AIAYN-creator/monkey-with-a-scalpel/docs/connection_map.md

# Connection map (generated by `python cad/connection_map.py`; provisional)

Every conductor from its pin in the electronics box to its pin at the machine. Pins of the controller come from `board_config.h`; cables, lengths and conductor counts from `cad/wiring.py`. Nothing here is measured or verified.

## C1: X motor (NEMA 17, at the crossbeam end) (0.7 m)

| # | Signal | Box end | Machine end |
|---|---|---|---|
| 1 | X motor coil A + | D_X.M1A | X motor.coilA+ |
| 2 | X motor coil A - | D_X.M1B | X motor.coilA- |
| 3 | X motor coil B + | D_X.M2A | X motor.coilB+ |
| 4 | X motor coil B - | D_X.M2B | X motor.coilB- |

## C3: Y motor (NEMA 17, on the X carriage) (1.2 m)

| # | Signal | Box end | Machine end |
|---|---|---|---|
| 1 | Y motor coil A + | D_Y.M1A | Y motor.coilA+ |
| 2 | Y motor coil A - | D_Y.M1B | Y motor.coilA- |
| 3 | Y motor coil B + | D_Y.M2A | Y motor.coilB+ |
| 4 | Y motor coil B - | D_Y.M2B | Y motor.coilB- |

## C5: Z motor (NEMA 17 dual shaft, on the Y carriage) (1.8 m)

| # | Signal | Box end | Machine end |
|---|---|---|---|
| 1 | Z motor coil A + | D_Z.M1A | Z motor.coilA+ |
| 2 | Z motor coil A - | D_Z.M1B | Z motor.coilA- |
| 3 | Z motor coil B + | D_Z.M2A | Z motor.coilB+ |
| 4 | Z motor coil B - | D_Z.M2B | Z motor.coilB- |

## C12: Wrist axis A motor (NEMA 11) (2.2 m)

| # | Signal | Box end | Machine end |
|---|---|---|---|
| 1 | Wrist A motor coil A + | D_A.M1A | Wrist A motor.coilA+ |
| 2 | Wrist A motor coil A - | D_A.M1B | Wrist A motor.coilA- |
| 3 | Wrist A motor coil B + | D_A.M2A | Wrist A motor.coilB+ |
| 4 | Wrist A motor coil B - | D_A.M2B | Wrist A motor.coilB- |

## C13: Wrist axis B motor (NEMA 11) (2.2 m)

| # | Signal | Box end | Machine end |
|---|---|---|---|
| 1 | Wrist B motor coil A + | D_B.M1A | Wrist B motor.coilA+ |
| 2 | Wrist B motor coil A - | D_B.M1B | Wrist B motor.coilA- |
| 3 | Wrist B motor coil B + | D_B.M2A | Wrist B motor.coilB+ |
| 4 | Wrist B motor coil B - | D_B.M2B | Wrist B motor.coilB- |

## C2: X limit switches, min and max (common ground) (0.7 m)

| # | Signal | Box end | Machine end |
|---|---|---|---|
| 1 | X minimum switch | U1.GPIO1 | SW_X-.NC |
| 2 | X maximum switch | U1.GPIO2 | SW_X+.NC |
| 3 | switch common ground | GND_LOGIC | SW_X-.C and SW_X+.C |

## C4: Y limit switches, min and max (common ground) (1.2 m)

| # | Signal | Box end | Machine end |
|---|---|---|---|
| 1 | Y minimum switch | U1.GPIO21 | SW_Y-.NC |
| 2 | Y maximum switch | U1.GPIO38 | SW_Y+.NC |
| 3 | switch common ground | GND_LOGIC | SW_Y-.C and SW_Y+.C |

## C6: Z limit switch, top (1.8 m)

| # | Signal | Box end | Machine end |
|---|---|---|---|
| 1 | Z top switch | U1.GPIO40 | SW_Z+.NC |
| 2 | switch common ground | GND_LOGIC | SW_Z+.C |

## C8: Control panel: dual-contact e-stop and ABORT button (coil, enable loop, ABORT signal), pilot LED, common ground (1.0 m)

| # | Signal | Box end | Machine end |
|---|---|---|---|
| 1 | contactor coil supply to e-stop contact 1 | K1.A1 via ES1.11 loop | ES1.11 |
| 2 | e-stop contact 1 to the contactor coil | K1.A2 side | ES1.12 |
| 3 | enable loop out (5 V) | ENABLE_5V | ES1.21 |
| 4 | enable loop return (ES1.22 to AB1.21 in the panel) | ENABLE_OK | AB1.22 |
| 5 | ABORT button contact 1 | U1.GPIO41 | AB1.11 |
| 6 | common ground | GND_LOGIC | AB1.12 and LED1.K |
| 7 | pilot LED | U1.GPIO47 via resistor | LED1.A |

## C7: Head link: tool power 24 V and ground, RS-485 pair, enable signal, power permit, plunger motor phases (see HEAD_LINK) (2.2 m)

| # | Signal | Box end | Machine end |
|---|---|---|---|
| 1 | tool rail 24 V (1) | K1.TOOL_FUSE | HB.VIN1 |
| 2 | tool rail 24 V (2) | K1.TOOL_FUSE | HB.VIN2 |
| 3 | tool rail ground (1) | GND_POWER | HB.GND1 |
| 4 | tool rail ground (2) | GND_POWER | HB.GND2 |
| 5 | RS-485 A | T1.A | T2.A |
| 6 | RS-485 B | T1.B | T2.B |
| 7 | enable loop | ENABLE_OK | HB.ENABLE |
| 8 | power permit | U1.GPIO39 | HB.PERMIT |
| 9 | plunger motor A + | D_P.M1A | HB.PA1 |
| 10 | plunger motor A - | D_P.M1B | HB.PA2 |
| 11 | plunger motor B + | D_P.M2A | HB.PB1 |
| 12 | plunger motor B - | D_P.M2B | HB.PB2 |

## C9: Camera A (USB) (2.0 m)

| # | Signal | Box end | Machine end |
|---|---|---|---|
| 1 | Camera A USB VBUS | PC.USB_VBUS | Camera A.VBUS |
| 2 | Camera A USB D+ | PC.USB_D+ | Camera A.D+ |
| 3 | Camera A USB D- | PC.USB_D- | Camera A.D- |
| 4 | Camera A USB GND | PC.USB_GND | Camera A.GND |

## C10: Camera B (USB) (2.0 m)

| # | Signal | Box end | Machine end |
|---|---|---|---|
| 1 | Camera B USB VBUS | PC.USB_VBUS | Camera B.VBUS |
| 2 | Camera B USB D+ | PC.USB_D+ | Camera B.D+ |
| 3 | Camera B USB D- | PC.USB_D- | Camera B.D- |
| 4 | Camera B USB GND | PC.USB_GND | Camera B.GND |

## C11: Host PC to the controller (USB serial) (1.5 m)

| # | Signal | Box end | Machine end |
|---|---|---|---|
| 1 | Host PC USB VBUS | PC.USB_VBUS | U1.USB_VBUS |
| 2 | Host PC USB D+ | PC.USB_D+ | U1.USB_D+ |
| 3 | Host PC USB D- | PC.USB_D- | U1.USB_D- |
| 4 | Host PC USB GND | PC.USB_GND | U1.USB_GND |

## Inside the electronics box

| Controller pin | Goes to | Function |
|---|---|---|
| U1.GPIO4 | D_X.STEP | X step |
| U1.GPIO5 | D_Y.STEP | Y step |
| U1.GPIO6 | D_Z.STEP | Z step |
| U1.GPIO7 | D_A.STEP | A step |
| U1.GPIO15 | D_B.STEP | B step |
| U1.GPIO16 | D_P.STEP | P step |
| U1.GPIO17 | D_X.DIR | X direction |
| U1.GPIO18 | D_Y.DIR | Y direction |
| U1.GPIO8 | D_Z.DIR | Z direction |
| U1.GPIO9 | D_A.DIR | A direction |
| U1.GPIO10 | D_B.DIR | B direction |
| U1.GPIO11 | D_P.DIR | P direction |
| U1.GPIO12 | D_X.EN, D_Y.EN, D_Z.EN, D_A.EN, D_B.EN, D_P.EN | drivers enable (low = on) |
| U1.GPIO42 | OPTO1.OUT | motor power OK, after the contactor |
| U1.GPIO13 | T1.DI | head link transmit (reclaims the reserved UART TX) |
| U1.GPIO14 | T1.RO | head link receive (reclaims the reserved UART RX) |

## Power and safety nets

| From | To | What |
|---|---|---|
| PSU24.+ | F1 (fuse) to K1 main contacts 13-14 | 24 V from the supply to the contactor |
| K1.14 | D_X.VM, D_Y.VM, D_Z.VM, D_A.VM, D_B.VM, D_P.VM and the tool rail fuse | 24 V after the contactor: motors and tools |
| K1.14 via divider | OPTO1.IN | motor power OK sense |
| PSU5.+ | U1.5V, D_*.VIO, T1.VCC, ENABLE_5V source | 5 V logic, separate from the motors |
| ENABLE_5V | C8.3 to ES1.21, ES1.22 to AB1.21, AB1.22 to C8.4 (ENABLE_OK), then C7.7 to HB.ENABLE | the enable loop |
| PSU24.+ via ES1.11-12 | K1.A1, K1.A2 to PSU24.- | the e-stop opens the contactor coil |

## Tool connector (12 circuits) on the head board, by tool

Circuits 1-2 switched 24 V, 3-4 ground, 5 logic 5 V, 6 identification (1-wire). Circuits 7-12 by tool:

| Tool | Circuit: signal (kind) |
|---|---|
| injector | 7: plunger motor A+ (phase); 8: plunger motor A- (phase); 9: plunger motor B+ (phase); 10: plunger motor B- (phase) |
| probe | 7: stylus trigger contact (NC to ground) (in); 11: stylus force, optional (analog) |
| scalpel | 7: guard servo (pwm); 8: guard closed sensor (in) |
| drill | 7: motor speed (pwm); 8: motor enable (out); 9: tachometer (in); 11: motor current (analog) |
| fluid | 7: pump 1 (pwm); 8: pump 2 (pwm); 9: line valve (out); 11: line pressure (analog) |
| gripper | 7: jaw motor A+ (phase); 8: jaw motor A- (phase); 9: jaw motor B+ (phase); 10: jaw motor B- (phase); 11: jaw force (analog) |
| cautery | 7: pulse gate (out); 11: tip current (analog) |
| sensor | 7: light source (pwm); 11: detector (analog) |

## Parts that must be fitted

- E-stop and ABORT button with two normally closed contacts each (dual contact): contact 1 for the contactor coil and the ABORT pin, contact 2 for the enable loop
- RS-485 transceivers with automatic direction control at the controller (T1) and at the head board (T2)
- Head board: microcontroller, high-side tool power switch and the discrete AND of the enable loop and the power permit (see wiring.py HEAD_BOARD and HW_CUTOFF_NOTE)
- Four changeover relays or analog switches on the head board that route circuits 7-10 either to the plunger motor phases or to the head outputs, selected from the tool identifier; unpowered, the circuits are disconnected from both
