AIAYN-creator/monkey-with-a-scalpel/assets/brand/social-preview.png

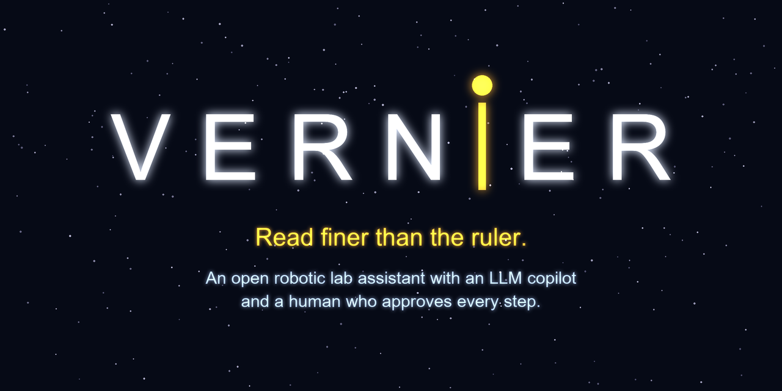
assets/brand/social-preview.png
