AIAYN-creator/monkey-with-a-scalpel/assets/brand/wordmark-dark.png

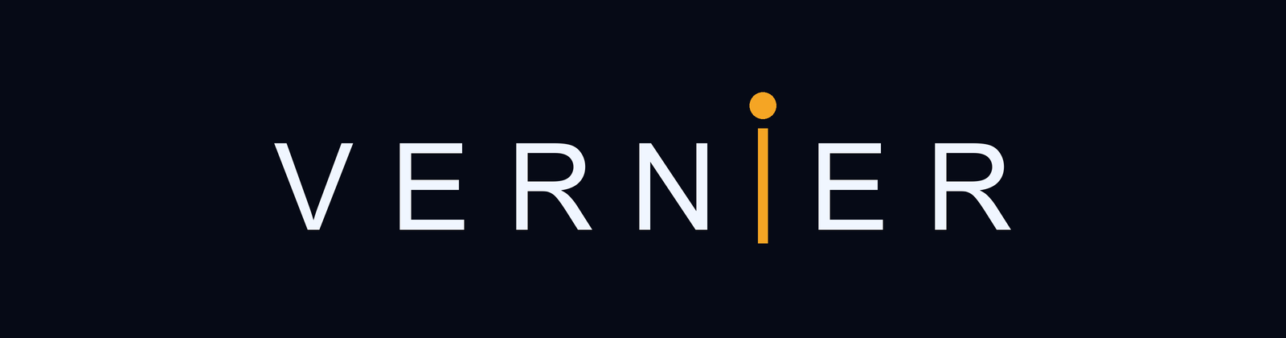
assets/brand/wordmark-dark.png
