AIAYN-creator/monkey-with-a-scalpel/assets/brand/wordmark-glow.png

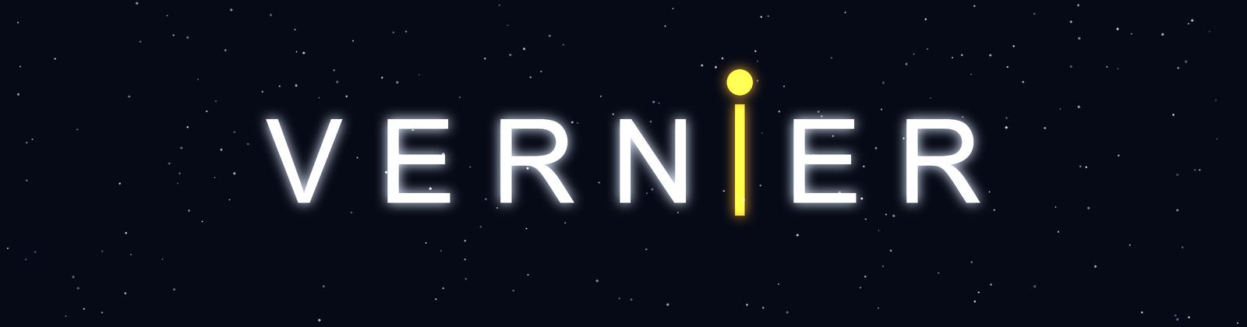
assets/brand/wordmark-glow.png
