AIAYN-creator/monkey-with-a-scalpel/docs/cad/system_100mm.png

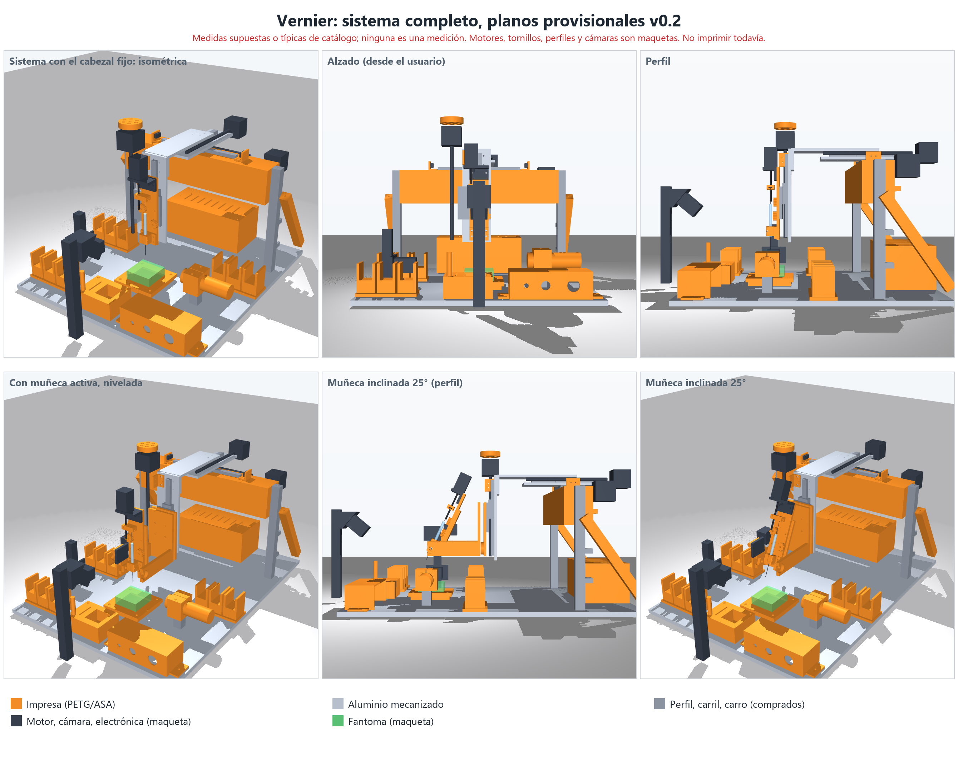
docs/cad/system_100mm.png
