AIAYN-creator/monkey-with-a-scalpel/docs/cad/tool_head.png

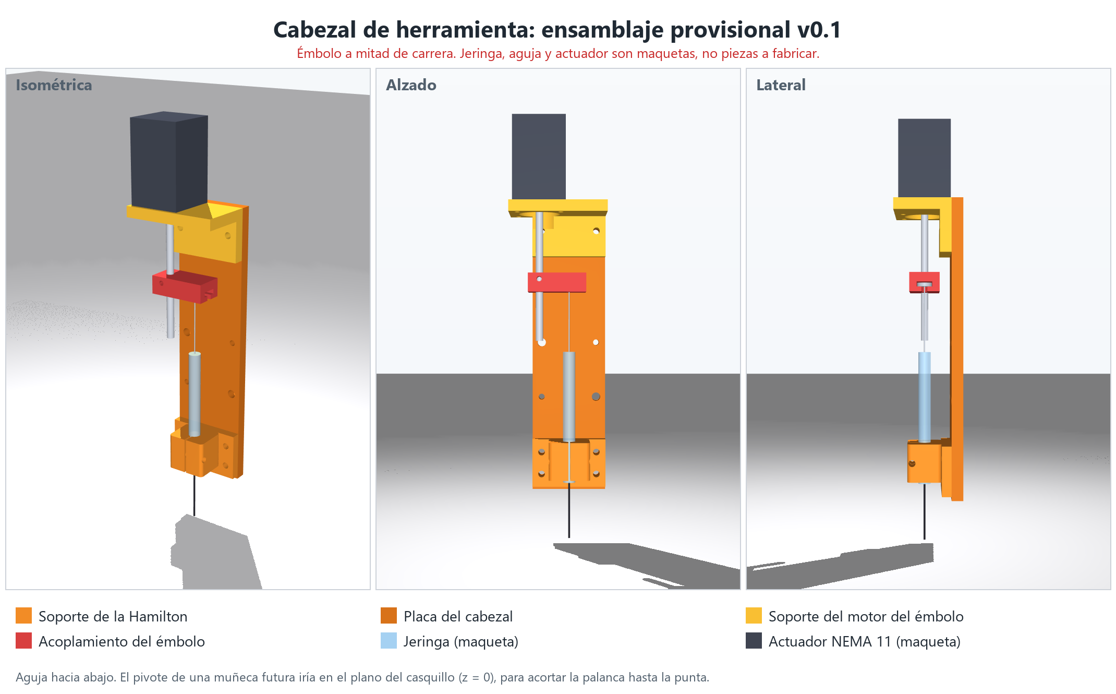
docs/cad/tool_head.png
