AIAYN-creator/monkey-with-a-scalpel/docs/connection_map.png

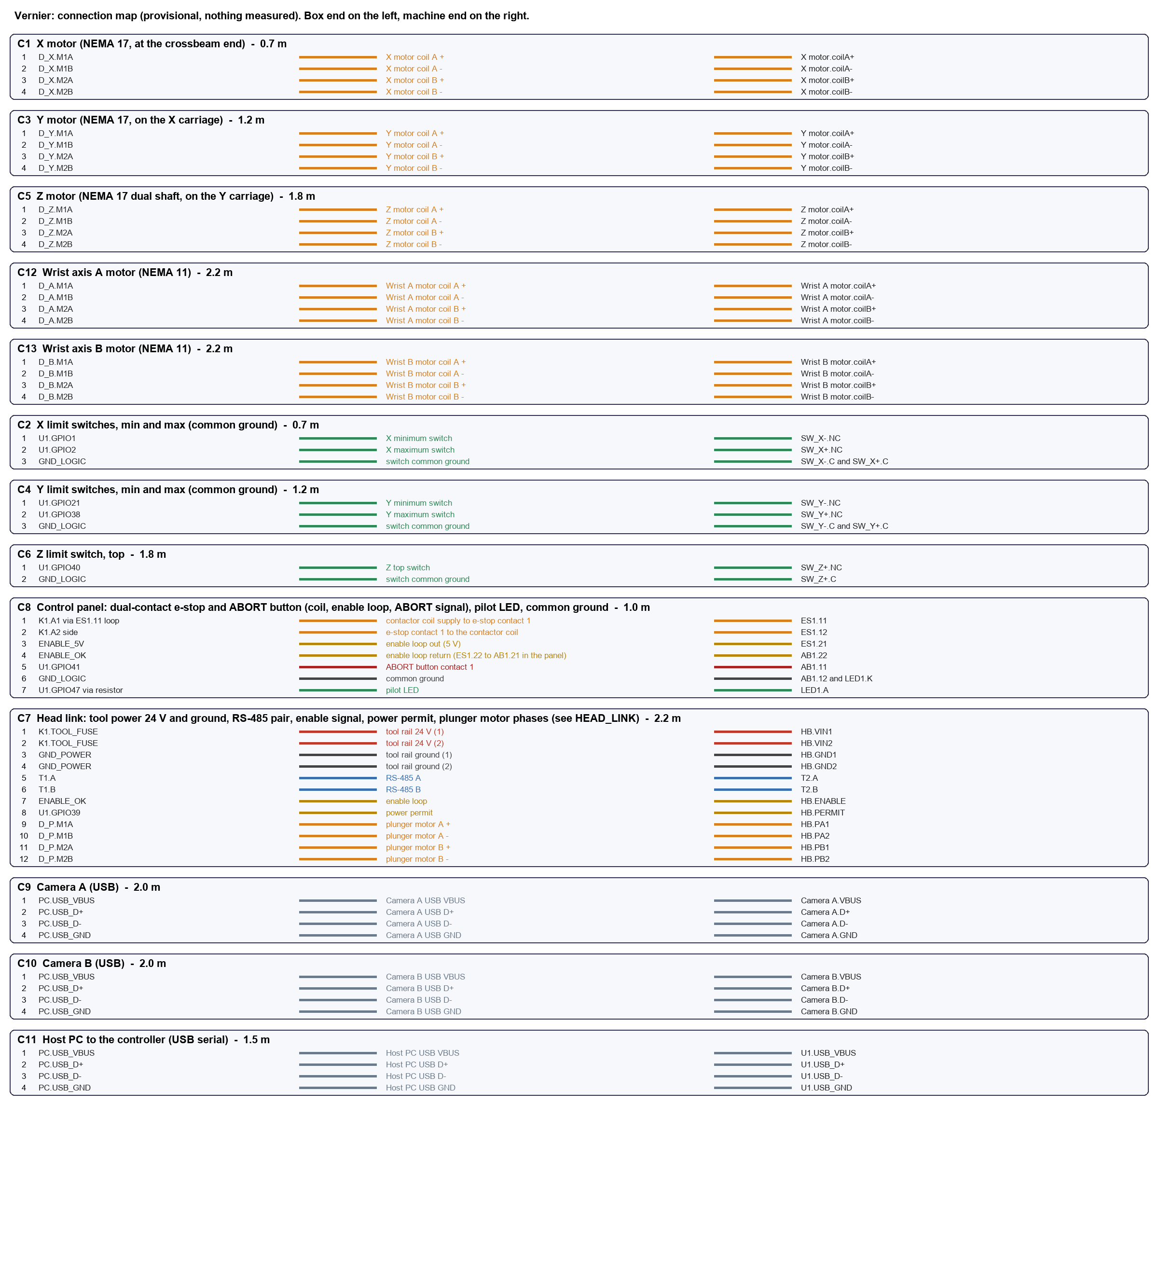
docs/connection_map.png
