AIAYN-creator/monkey-with-a-scalpel/docs/cad/parts.png

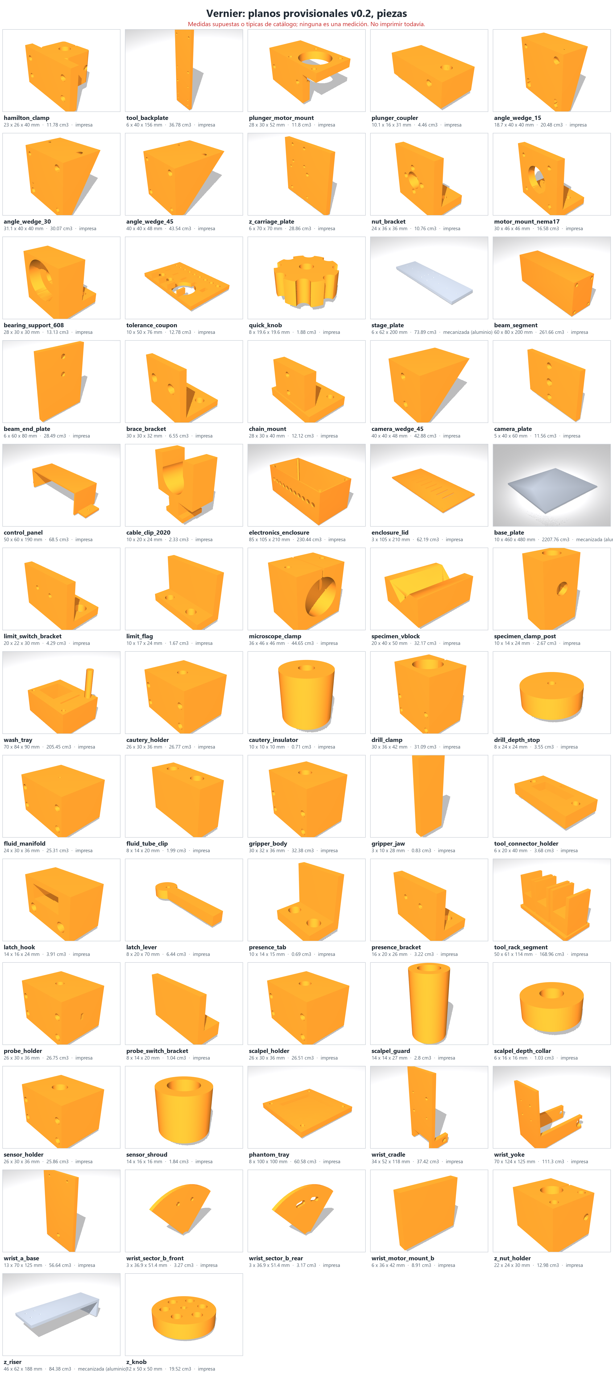
docs/cad/parts.png
