AIAYN-creator/monkey-with-a-scalpel/docs/wiring_blocks.png

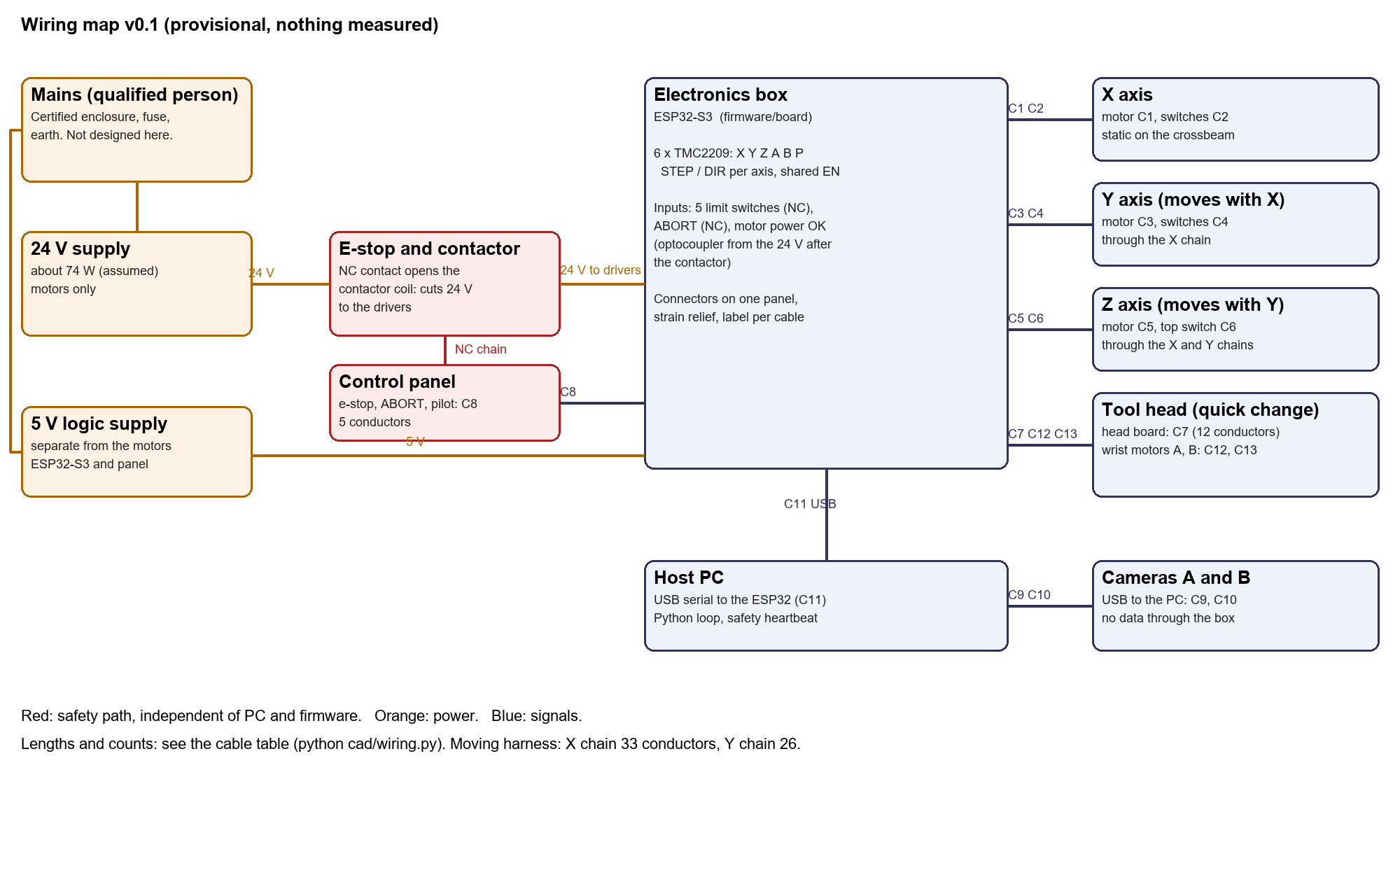
docs/wiring_blocks.png
