AIAYN-creator/monkey-with-a-scalpel/cad/wiring.py

"""Provisional wiring map: components, connections, cable groups and estimated lengths, checked against the firmware pins.

Usage, from the repository root:
    python cad/wiring.py            print the tables as Markdown
    python cad/wiring.py --check    consistency checks (used by the CI), exit code 1 on a problem
    python cad/wiring.py --diagram out/wiring.png    draw the block diagram (needs Pillow)

The tool interface follows the contract of the card dec-iface: one 12-circuit connector per tool, the wrist motors are machine cables, and
every tool is checked against its descriptor (tools/<name>/descriptor.yaml). The 12 circuits end on a small head board on the Z carriage,
which talks to the controller over an RS-485 pair, so the controller needs three GPIOs for all eight tools. Nothing here is a verified design. Lengths come from the provisional CAD parameters plus assumed routes; currents and
connectors are typical values to confirm against the datasheets of what is bought. The mains side and the
motor-power cut-off must be built and reviewed by a qualified person. Pins are read from
firmware/board/controller_board/board_config.h so the map cannot drift from the firmware.
"""
import re
import sys
from pathlib import Path

import params as P

ROOT = Path(__file__).resolve().parents[1]
BOARD_CONFIG = ROOT / "firmware" / "board" / "controller_board" / "board_config.h"
AXES = ["X", "Y", "Z", "A", "B", "P"]


def read_pins():
    """Pin numbers declared in board_config.h, as {name: list or int}."""
    text = BOARD_CONFIG.read_text(encoding="utf-8")
    pins = {}
    for name, body in re.findall(r"constexpr std::array<int, kAxes> (k\w+)\{([^}]*)\}", text):
        pins[name] = [-1 if item.strip() == "kNoPin" else int(item) for item in body.split(",")]
    for name, value in re.findall(r"constexpr int (k\w*(?:Pin|Tx|Rx)\w*) = (\d+);", text):
        pins[name] = int(value)
    return pins


PINS = read_pins()

# --- cables -------------------------------------------------------------------------------------------------------
# Where each thing sits along the route from the electronics box. Lengths in metres, from the CAD parameters.
BOX_TO_UPRIGHT = 0.25  # assumed: the box stands next to an upright
UPRIGHT = P.CROSSBEAM_TOP / 1000
BEAM_END = P.UPRIGHT_X / 1000  # worst case: the far end of the crossbeam
X_CHAIN = P.TRAVEL_X / 1000 + 0.15  # cable allowance for the X travel plus the bend of the chain
Y_CHAIN = P.TRAVEL_Y / 1000 + 0.15
REACH = (P.ARM_REACH + 100) / 1000  # along the Y plate and the riser to the Z plate
Z_DROP = (P.TRAVEL_Z + 225) / 1000  # down the Z plate to the tool head (head height 225 mm)
SLACK = 1.15  # 15 % for strain relief and service loops
STATIC_X = BOX_TO_UPRIGHT + UPRIGHT + BEAM_END
STATIC_END = BOX_TO_UPRIGHT + UPRIGHT + BEAM_END * 0.1


def metres(value):
    return round(value * SLACK + 0.1, 1)  # plus 0.1 m at the box end


# (id, what, conductors, shielded, moves, length_m, connector at the machine end)
CABLES = [
    ("C1", "X motor (NEMA 17, at the crossbeam end)", 4, True, False, metres(STATIC_END), "4-pin JST-XH or screw terminal"),
    ("C2", "X limit switches, min and max (common ground)", 3, False, False, metres(STATIC_END), "3-pin JST-XH"),
    ("C3", "Y motor (NEMA 17, on the X carriage)", 4, True, True, metres(STATIC_X + X_CHAIN), "4-pin JST-XH"),
    ("C4", "Y limit switches, min and max (common ground)", 3, False, True, metres(STATIC_X + X_CHAIN), "3-pin JST-XH"),
    ("C5", "Z motor (NEMA 17 dual shaft, on the Y carriage)", 4, True, True,
     metres(STATIC_X + X_CHAIN + Y_CHAIN + REACH), "4-pin JST-XH"),
    ("C6", "Z limit switch, top", 2, False, True, metres(STATIC_X + X_CHAIN + Y_CHAIN + REACH), "2-pin JST-XH"),
    ("C7", "Head link: tool power 24 V and ground, RS-485 pair, enable signal, power permit, plunger motor phases (see HEAD_LINK)", 12, True, True,
     metres(STATIC_X + X_CHAIN + Y_CHAIN + REACH + Z_DROP), "12-pin connector on the head board (Z carriage)"),
    ("C8", "Control panel: dual-contact e-stop and ABORT button (coil, enable loop, ABORT signal), pilot LED, common ground", 7, False, False, 1.0, "7-pin JST-XH"),
    ("C9", "Camera A (USB)", 4, True, False, 2.0, "USB, cable with ferrite"),
    ("C10", "Camera B (USB)", 4, True, False, 2.0, "USB, cable with ferrite"),
    ("C11", "Host PC to the controller (USB serial)", 4, True, False, 1.5, "USB"),
    ("C12", "Wrist axis A motor (NEMA 11)", 4, True, True, metres(STATIC_X + X_CHAIN + Y_CHAIN + REACH + Z_DROP), "4-pin JST-XH, fixed to the wrist"),
    ("C13", "Wrist axis B motor (NEMA 11)", 4, True, True, metres(STATIC_X + X_CHAIN + Y_CHAIN + REACH + Z_DROP), "4-pin JST-XH, fixed to the wrist"),
]

# Conductors that travel through the X chain and through the Y chain (the moving harness)
MOVING = {
    "X chain": ["C3", "C4", "C5", "C6", "C7", "C12", "C13"],
    "Y chain": ["C5", "C6", "C7", "C12", "C13"],
}

# --- power --------------------------------------------------------------------------------------------------------
# Assumed currents (typical, to confirm): motor current set on each TMC2209 module, motor supply 24 V.
MOTOR_CURRENT_A = {"X": 1.0, "Y": 1.0, "Z": 1.0, "A": 0.8, "B": 0.8, "P": 0.6}
COIL_RESISTANCE_OHM = 2.0  # assumed, typical NEMA 17 / NEMA 11 range 1.5 to 3
SUPPLY_V = 24.0
SUPPLY_MARGIN = 4.0  # headroom over the holding dissipation for acceleration, losses and the drivers' own supply


def power_budget():
    """Order-of-magnitude sizing. Holding dissipation is two coils at the set current: 2 I^2 R per motor. The supply
    is chosen with a large margin because motion needs far more than holding. A hypothesis, not a measurement."""
    holding = sum(2 * i * i * COIL_RESISTANCE_OHM for i in MOTOR_CURRENT_A.values())
    return holding, holding * SUPPLY_MARGIN


# --- tool interface -----------------------------------------------------------------------------------------------
# Contract of the card dec-iface: circuits 1-2 switched 24 V, 3-4 ground, 5 logic 5 V, 6 identification (1-wire), 7-10 four signals or motor
# phases, 11-12 spare or analog input. Each tool says what it puts on 7-12 and which of those the controller must drive or read.
CONNECTOR_CIRCUITS = 12
POWER_CIRCUITS = 2
AMPS_PER_CIRCUIT = 3.0  # assumed contact rating of a 2.5 mm pitch connector
DERATING = 0.7
SIGNAL_CIRCUITS = (7, 8, 9, 10)
ANALOG_CIRCUITS = (11, 12)
KINDS = {"phase", "pwm", "out", "in", "analog"}

# tool name -> {circuit: (signal, kind)}; the kinds say which controller resource is needed
TOOL_WIRING = {
    "injector": {7: ("plunger motor A+", "phase"), 8: ("plunger motor A-", "phase"), 9: ("plunger motor B+", "phase"), 10: ("plunger motor B-", "phase")},
    "probe": {7: ("stylus trigger contact (NC to ground)", "in"), 11: ("stylus force, optional", "analog")},
    "scalpel": {7: ("guard servo", "pwm"), 8: ("guard closed sensor", "in")},
    "drill": {7: ("motor speed", "pwm"), 8: ("motor enable", "out"), 9: ("tachometer", "in"), 11: ("motor current", "analog")},
    "fluid": {7: ("pump 1", "pwm"), 8: ("pump 2", "pwm"), 9: ("line valve", "out"), 11: ("line pressure", "analog")},
    "gripper": {7: ("jaw motor A+", "phase"), 8: ("jaw motor A-", "phase"), 9: ("jaw motor B+", "phase"), 10: ("jaw motor B-", "phase"),
                11: ("jaw force", "analog")},
    "cautery": {7: ("pulse gate", "out"), 11: ("tip current", "analog")},
    "sensor": {7: ("light source", "pwm"), 11: ("detector", "analog")},
}

# Pins. The ESP32-S3 board has one free GPIO (39) and the reserved TMC2209 UART pair (13, 14), which the standalone drivers do not use. That
# is enough because the tool circuits do not come to the controller one by one: they end on a head board (below).
TOOL_PINS = {"head_uart_tx": 13, "head_uart_rx": 14, "tool_power_permit": 39}

# The head board sits on the Z carriage, next to the tool. A small microcontroller (ESP32-C3 class, the same toolchain as the controller) with a local 5 V and 3.3 V supply from the
# tool rail. It reads the identification memory (1-wire) and the presence switch, drives circuits 7-10 (PWM, digital, motor phases are
# passed straight through from the P driver) and reads circuits 11-12 (ADC), and switches the tool power with a high-side switch. It answers
# the controller on the RS-485 link, and it cuts the tool outputs and the power by itself if the link is silent for 200 ms.
HEAD_BOARD = {
    "mcu": "ESP32-C3 class, 3.3 V (RISC-V, 5 ADC channels, PWM and UART in hardware)",
    "link": "RS-485 half duplex over the pair A, B of C7, 115200 baud, auto-direction transceiver at each end (2 GPIOs on the controller)",
    "watchdog_ms": 200,
    "inputs": "1-wire identification (circuit 6), presence switch, digital inputs of circuits 7-10, two ADC channels (circuits 11-12)",
    "outputs": "four PWM or digital outputs (circuits 7-10), high-side tool power switch, status LED",
}
# Conductors of C7 (12). The enable loop is a 5 V loop in the electronics box that goes through the second contact of the e-stop and of
# the ABORT button (dual-contact parts) and back to the head board: it is closed only while both are released.
HEAD_LINK = [
    ("tool rail 24 V", 2), ("tool rail ground", 2), ("RS-485 A", 1), ("RS-485 B", 1), ("enable loop", 1),
    ("power permit from GPIO 39", 1), ("plunger motor A+ and A-", 2), ("plunger motor B+ and B-", 2),
]
HW_CUTOFF_NOTE = ("on the head board, a series switch on the tool 24 V that conducts only while three things hold at once: the enable loop is "
                  "closed (e-stop and ABORT released), the controller asserts the power permit (GPIO 39) and the head microcontroller asks for "
                  "power. It is built from discrete logic (an AND of the first two feeding the gate), so it opens on its own, without any software")
PIN_FORBIDDEN = {0, 3, 19, 20, 43, 44, 45, 46, 48} | set(range(26, 38))


def read_descriptors():
    """{name: {key: value}} for tools/*/descriptor.yaml (the small YAML subset of tools/README.md)."""
    found = {}
    for path in sorted((ROOT / "tools").glob("*/descriptor.yaml")):
        flat, section = {}, None
        for raw in path.read_text(encoding="utf-8").splitlines():
            if not raw.strip() or raw.lstrip().startswith("#"):
                continue
            key, _, value = raw.strip().partition(":")
            value = value.strip()
            if raw.startswith(" ") and section:
                flat[f"{section}.{key}"] = value
            elif value == "":
                section = key
            else:
                section = None
                flat[key] = value
        found[flat["name"]] = flat
    return found


def tool_table():
    rows = []
    for name, desc in read_descriptors().items():
        wiring = TOOL_WIRING.get(name, {})
        used = ", ".join(f"{c}: {s}" for c, (s, _k) in sorted(wiring.items())) or "none"
        rows.append((name, desc["id"], desc["power.max_current_a"], desc["power.hw_cutoff"], desc["power.cut_on_abort"], used))
    return rows


def tool_power_w():
    """Largest tool power: one tool is powered at a time."""
    return max(float(d["power.max_current_a"]) for d in read_descriptors().values()) * SUPPLY_V


def check_tools():
    problems = []
    descriptors = read_descriptors()
    for name in descriptors:
        if name not in TOOL_WIRING:
            problems.append(f"tool {name} has no connector assignment")
    for name in TOOL_WIRING:
        if name not in descriptors:
            problems.append(f"connector assignment for {name}, which has no descriptor")
    capacity = POWER_CIRCUITS * AMPS_PER_CIRCUIT * DERATING
    for name, desc in descriptors.items():
        wiring = TOOL_WIRING.get(name, {})
        amps = float(desc["power.max_current_a"])
        if amps > capacity:
            problems.append(f"tool {name} draws up to {amps} A, the two power circuits carry {capacity:.1f} A")
        for circuit, (_signal, kind) in wiring.items():
            if circuit not in SIGNAL_CIRCUITS + ANALOG_CIRCUITS:
                problems.append(f"tool {name} uses circuit {circuit}, which is not a signal circuit")
            if kind not in KINDS:
                problems.append(f"tool {name} circuit {circuit} has an unknown kind {kind}")
            if kind == "analog" and circuit not in ANALOG_CIRCUITS:
                problems.append(f"tool {name} puts an analog signal on circuit {circuit}")
            if circuit in ANALOG_CIRCUITS and kind != "analog":
                problems.append(f"tool {name} puts a {kind} signal on the analog circuit {circuit}")
        uses_p = "P" in desc["axes"]
        phases = sum(1 for _s, k in wiring.values() if k == "phase")
        if uses_p and phases != 4:
            problems.append(f"tool {name} uses the P axis and needs exactly 4 motor-phase circuits, it has {phases}")
        if not uses_p and phases:
            problems.append(f"tool {name} has motor phases but does not use the P axis")
        if desc["class"] in ("drill", "cautery") and desc["power.hw_cutoff"] != "true":
            problems.append(f"tool {name} must have a hardware cut-off")
    # pins: the three new ones must be free, allowed, and the reclaimed ones must be the reserved UART pair
    used = {v for k, v in PINS.items() if isinstance(v, int) and v >= 0 and k not in ("kReservedUartTx", "kReservedUartRx")}
    used |= {p for v in PINS.values() if isinstance(v, list) for p in v if p >= 0}
    if {TOOL_PINS["head_uart_tx"], TOOL_PINS["head_uart_rx"]} != {PINS["kReservedUartTx"], PINS["kReservedUartRx"]}:
        problems.append("the head link UART is not on the reserved TMC2209 UART pair")
    for name, pin in TOOL_PINS.items():
        if pin in used:
            problems.append(f"{name} (GPIO {pin}) is already used")
        if pin in PIN_FORBIDDEN:
            problems.append(f"{name} (GPIO {pin}) is a forbidden pin of the board")
    if len(set(TOOL_PINS.values())) != len(TOOL_PINS):
        problems.append("a tool pin is used twice")
    conductors = {c[0]: c[2] for c in CABLES}
    if sum(n for _what, n in HEAD_LINK) != conductors["C7"]:
        problems.append(f"HEAD_LINK has {sum(n for _w, n in HEAD_LINK)} conductors, C7 has {conductors['C7']}")
    # the head board resources
    pwm = max(sum(1 for _s, k in w.values() if k in ("pwm", "out")) for w in TOOL_WIRING.values())
    inputs = max(sum(1 for _s, k in w.values() if k == "in") for w in TOOL_WIRING.values())
    adc = max(sum(1 for _s, k in w.values() if k == "analog") for w in TOOL_WIRING.values())
    if pwm > 4 or pwm + inputs > 4 or adc > 2:
        problems.append("a tool needs more head board channels than circuits 7-12 provide")
    return problems


# --- tables -------------------------------------------------------------------------------------------------------
def pin_table():
    rows = []
    for index, axis in enumerate(AXES):
        rows.append((f"{axis} step", PINS["kStepPin"][index], f"TMC2209 {axis} STEP"))
        rows.append((f"{axis} direction", PINS["kDirPin"][index], f"TMC2209 {axis} DIR"))
    rows.append(("Drivers enable (shared, low = on)", PINS["kEnablePin"], "EN of the six TMC2209"))
    for index, axis in enumerate(AXES):
        if PINS["kLimitMinPin"][index] >= 0:
            rows.append((f"{axis} minimum switch", PINS["kLimitMinPin"][index], "NC to ground, pull-up"))
        if PINS["kLimitMaxPin"][index] >= 0:
            rows.append((f"{axis} maximum switch", PINS["kLimitMaxPin"][index], "NC to ground, pull-up"))
    rows.append(("ABORT button", PINS["kAbortPin"], "NC to ground, pull-up"))
    rows.append(("Motor power OK", PINS["kPowerOkPin"], "from an optocoupler, pull-down"))
    rows.append(("Pilot LED", PINS["kLedPin"], "LED with series resistor"))
    rows.append(("Reserved: TMC2209 UART", f"{PINS['kReservedUartTx']} (TX), {PINS['kReservedUartRx']} (RX)", "not used in standalone mode"))
    return rows


def markdown():
    out = ["## Cables\n", "| Id | Cable | Conductors | Shielded | Moves | Length (m) | Connector at the machine end |",
           "|---|---|---|---|---|---|---|"]
    for cid, what, n, shield, moves, length, conn in CABLES:
        out.append(f"| {cid} | {what} | {n} | {'yes' if shield else 'no'} | {'yes' if moves else 'no'} | {length} | {conn} |")
    out.append("\n## Moving harness\n")
    out.append("| Section | Cables | Conductors |\n|---|---|---|")
    counts = {c[0]: c[2] for c in CABLES}
    for section, ids in MOVING.items():
        out.append(f"| {section} | {', '.join(ids)} | {sum(counts[i] for i in ids)} |")
    out.append("\n## Pins\n")
    out.append("| Signal | GPIO | Wiring |\n|---|---|---|")
    for signal, pin, note in pin_table():
        out.append(f"| {signal} | {pin} | {note} |")
    out.append("\n## Tool connector (12 circuits, contract of dec-iface)\n")
    out.append("| Tool | Id | Max current (A) | Hardware cut-off | Cut on abort | Circuits 7 to 12 |\n|---|---|---|---|---|---|")
    for name, ident, amps, cutoff, cut, used in tool_table():
        out.append(f"| {name} | {ident} | {amps} | {cutoff} | {cut} | {used} |")
    out.append("\nCircuits 1-2 switched 24 V, 3-4 ground, 5 logic 5 V, 6 identification (1-wire).")
    out.append("\n## Head board and the three controller pins for the tools (proposed, not yet in the firmware)\n")
    out.append("| Signal | GPIO | Note |\n|---|---|---|")
    notes = {"head_uart_tx": "reclaims kReservedUartTx, to the RS-485 transceiver", "head_uart_rx": "reclaims kReservedUartRx, from the RS-485 transceiver",
             "tool_power_permit": "own wire in C7, off after a reset"}
    for signal, pin in TOOL_PINS.items():
        out.append(f"| {signal} | {pin} | {notes[signal]} |")
    out.append("\n| Head board | |\n|---|---|")
    for key, value in HEAD_BOARD.items():
        out.append(f"| {key} | {value} |")
    out.append("\n| C7 conductors | Count |\n|---|---|")
    for what, count in HEAD_LINK:
        out.append(f"| {what} | {count} |")
    out.append(f"\nHardware cut-off (drill, cautery): {HW_CUTOFF_NOTE}.")
    holding, supply = power_budget()
    out.append(f"\n## Motor power (assumed)\n\nMotor currents set on the drivers: {MOTOR_CURRENT_A} A, coil resistance "
               f"{COIL_RESISTANCE_OHM:g} ohm. Holding dissipation about {holding:.0f} W; with a margin of {SUPPLY_MARGIN:g}x, a "
               f"{SUPPLY_V:g} V supply of about {supply:.0f} W ({supply / SUPPLY_V:.1f} A). One tool is powered at a time, up to "
               f"{tool_power_w():.0f} W on the switched tool rail (the largest descriptor), included in that margin.")
    return "\n".join(out)


# --- checks -------------------------------------------------------------------------------------------------------
def check():
    problems = []
    pins = [v for k, v in PINS.items() if isinstance(v, int) and v >= 0] + [
        p for k, v in PINS.items() if isinstance(v, list) for p in v if p >= 0]
    if len(pins) != len(set(pins)):
        problems.append("a GPIO is used twice")
    ids = [c[0] for c in CABLES]
    if len(ids) != len(set(ids)):
        problems.append("repeated cable id")
    if any(i not in ids for section in MOVING.values() for i in section):
        problems.append("a moving harness lists an unknown cable")
    for cid, _, _, _, moves, length, _ in CABLES:
        if length <= 0:
            problems.append(f"{cid} has no length")
        if any(cid in section for section in MOVING.values()) != moves:
            problems.append(f"{cid} moving flag disagrees with the harness list")
    # every fitted switch pin of the firmware has a cable conductor: X two, Y two, Z one
    fitted = sum(1 for v in PINS["kLimitMinPin"] + PINS["kLimitMaxPin"] if v >= 0)
    if fitted != 5:
        problems.append(f"the firmware fits {fitted} limit switches, the wiring map assumes 5")
    for axis in ("X", "Y", "Z"):
        if PINS["kStepPin"][AXES.index(axis)] < 0:
            problems.append(f"axis {axis} has no step pin")
    problems += check_tools()
    return problems


# --- diagram ------------------------------------------------------------------------------------------------------
def diagram(path):
    from PIL import Image, ImageDraw, ImageFont

    w, h = 2000, 1250
    image = Image.new("RGB", (w, h), "white")
    draw = ImageDraw.Draw(image)
    try:
        font = ImageFont.truetype("arial.ttf", 22)
        bold = ImageFont.truetype("arialbd.ttf", 26)
        small = ImageFont.truetype("arial.ttf", 18)
    except OSError:
        font = bold = small = ImageFont.load_default()

    def box(x, y, bw, bh, title, lines=(), fill="#eef3fb", outline="#335"):
        draw.rounded_rectangle((x, y, x + bw, y + bh), 14, fill=fill, outline=outline, width=3)
        draw.text((x + 14, y + 10), title, fill="black", font=bold)
        for i, line in enumerate(lines):
            draw.text((x + 14, y + 46 + 26 * i), line, fill="#222", font=small)
        return (x, y, bw, bh)

    def line(a, b, label="", color="#333", width=4, dash=False, dy=0):
        if dash:
            n = 24
            for i in range(0, n, 2):
                p = (a[0] + (b[0] - a[0]) * i / n, a[1] + (b[1] - a[1]) * i / n)
                q = (a[0] + (b[0] - a[0]) * (i + 1) / n, a[1] + (b[1] - a[1]) * (i + 1) / n)
                draw.line((p, q), fill=color, width=width)
        else:
            draw.line((a, b), fill=color, width=width)
        if label:
            draw.text(((a[0] + b[0]) / 2 - 60, (a[1] + b[1]) / 2 - 26 + dy), label, fill=color, font=small)

    draw.text((30, 20), "Wiring map v0.1 (provisional, nothing measured)", fill="black", font=bold)
    # mains and power
    box(30, 110, 330, 150, "Mains (qualified person)", ["Certified enclosure, fuse,", "earth. Not designed here."], "#fdf1e3", "#a60")
    box(30, 330, 330, 150, "24 V supply", [f"about {power_budget()[1]:.0f} W (assumed)", "motors only"], "#fdf1e3", "#a60")
    box(30, 580, 330, 130, "5 V logic supply", ["separate from the motors", "ESP32-S3 and panel"], "#fdf1e3", "#a60")
    # estop chain
    box(470, 330, 330, 150, "E-stop and contactor", ["NC contact opens the", "contactor coil: cuts 24 V", "to the drivers"], "#fdebeb", "#a22")
    # electronics box
    box(920, 110, 520, 560, "Electronics box", ["ESP32-S3  (firmware/board)", "", "6 x TMC2209: X Y Z A B P", "  STEP / DIR per axis, shared EN", "", "Inputs: 5 limit switches (NC),",
                                                 "ABORT (NC), motor power OK", "(optocoupler from the 24 V after", "the contactor)", "", "Connectors on one panel,", "strain relief, label per cable"])
    # machine
    box(1560, 110, 410, 120, "X axis", ["motor C1, switches C2", "static on the crossbeam"])
    box(1560, 260, 410, 120, "Y axis (moves with X)", ["motor C3, switches C4", "through the X chain"])
    box(1560, 410, 410, 120, "Z axis (moves with Y)", ["motor C5, top switch C6", "through the X and Y chains"])
    box(1560, 560, 410, 150, "Tool head (quick change)", ["head board: C7 (12 conductors)", "wrist motors A, B: C12, C13"])
    # panel and PC
    box(470, 520, 330, 110, "Control panel", ["e-stop, ABORT, pilot: C8", "5 conductors"], "#fdebeb", "#a22")
    box(920, 800, 520, 130, "Host PC", ["USB serial to the ESP32 (C11)", "Python loop, safety heartbeat"])
    box(1560, 800, 410, 130, "Cameras A and B", ["USB to the PC: C9, C10", "no data through the box"])
    # legend
    draw.text((30, 1010), "Red: safety path, independent of PC and firmware.   Orange: power.   Blue: signals.", fill="black", font=font)
    draw.text((30, 1050), "Lengths and counts: see the cable table (python cad/wiring.py). Moving harness: X chain "
              f"{sum(c[2] for c in CABLES if c[0] in MOVING['X chain'])} conductors, Y chain {sum(c[2] for c in CABLES if c[0] in MOVING['Y chain'])}.",
              fill="black", font=font)
    # links
    line((14, 185), (30, 185), "", "#a60")
    line((14, 185), (14, 645), "", "#a60")
    line((14, 645), (30, 645), "", "#a60")
    line((195, 260), (195, 330), "", "#a60")
    line((360, 405), (470, 405), "24 V", "#a60")
    line((800, 405), (920, 405), "24 V to drivers", "#a60", dy=-4)
    line((360, 650), (920, 650), "5 V", "#a60", dy=-4)
    line((635, 480), (635, 520), "", "#a22")
    draw.text((650, 488), "NC chain", fill="#a22", font=small)
    line((800, 575), (920, 575), "C8", "#335")
    line((1440, 170), (1560, 170), "C1 C2", "#335")
    line((1440, 320), (1560, 320), "C3 C4", "#335")
    line((1440, 470), (1560, 470), "C5 C6", "#335")
    line((1440, 635), (1560, 635), "C7 C12 C13", "#335")
    line((1180, 670), (1180, 800), "C11 USB", "#335")
    line((1440, 865), (1560, 865), "C9 C10", "#335")
    image.save(path)


if __name__ == "__main__":
    if "--check" in sys.argv:
        found = check()
        for item in found:
            print("PROBLEM:", item)
        if not found:
            print("WIRING CHECK OK")
        sys.exit(1 if found else 0)
    if "--diagram" in sys.argv:
        diagram(sys.argv[sys.argv.index("--diagram") + 1])
        sys.exit(0)
    print(markdown())
