AIAYN-creator/monkey-with-a-scalpel/tools/injector/descriptor.yaml

# Tool descriptor: the single source of the firmware tool table, the host plugin and the integration checks.
# Schema and rules: tools/README.md. Every number is provisional until measured (cards meas-tools and rev-tools).
id: 1
name: injector
class: injector
mass_g: 200
tip_mm: [0, 0, -30]
retract_mm: 20
axes: [P]
power:
  max_current_a: 1.0
  hw_cutoff: false
  cut_on_abort: false
safe_state: stop the plunger and withdraw the needle along its own axis
capabilities: [inject, prime, wash]
limits:
  syringe_ul: 10
  stroke_mm: 60
  lead_mm: 2.0
  microsteps: 16
  max_rate_ul_s: 2.0
  max_dose_ul: 5.0
