AIAYN-creator/monkey-with-a-scalpel/firmware/tests/mutation_check.py

"""Mutation check of the host tests: injects one safety fault at a time into the controller and requires the tests to fail.

Usage, from the repository root:
    python firmware/tests/mutation_check.py

A mutant that the tests do not catch (a "survivor") means a safety rule has no test. Exit code 1 if any survives.
Repeat it whenever the controller or the tests change, and when the board layer is added.
"""
import subprocess
import sys
import tempfile
from pathlib import Path

ROOT = Path(__file__).resolve().parents[2]
CORE = ROOT / "firmware" / "core"
BOARD = ROOT / "firmware" / "board" / "controller_board"
TESTS = ROOT / "firmware" / "tests"

# target -> (file that is mutated, test suites, directories on the include path). A suite is the list of sources compiled into one
# test program; a mutant is killed when ANY suite of its target fails.
TARGETS = {
    "controller": (CORE / "controller.cpp", [[CORE / "controller.cpp", TESTS / "test_controller.cpp"],
                                             [CORE / "controller.cpp", TESTS / "test_fuzz.cpp"],
                                             [CORE / "controller.cpp", TESTS / "test_tools.cpp"]], [CORE]),
    "step_queue": (CORE / "step_queue.h", [[TESTS / "test_board.cpp"]], [CORE, BOARD]),
    "board_config": (BOARD / "board_config.h", [[TESTS / "test_board.cpp"]], [CORE, BOARD]),
}

# (target, name, text that must occur exactly once in the target file, replacement)
MUTANTS = [
    ("controller", "soft limit minimum ignored", "target[i] < config_.axis[i].min_pos - 1e-9", "target[i] < config_.axis[i].min_pos - 1e3"),
    ("controller", "soft limit maximum ignored", "target[i] > config_.axis[i].max_pos + 1e-9", "target[i] > config_.axis[i].max_pos + 1e3"),
    ("controller", "move beyond limits accepted", 'if (!within_soft_limits(target)) return "error:limit";', ""),
    ("controller", "watchdog never fires", "now_ms - last_rx_ms_ > config_.watchdog_ms", "now_ms - last_rx_ms_ > config_.watchdog_ms * 1000"),
    ("controller", "abort button ignored", "if (in.abort_button) request_abort(Cause::Button);", ""),
    ("controller", "limit switch hit ignored (minimum side)", "if ((in.limit_min[i] && out.step_delta[i] < 0) ||", "if ((false && out.step_delta[i] < 0) ||"),
    ("controller", "limit switch hit ignored (maximum side)", "(in.limit_max[i] && out.step_delta[i] > 0)) {", "(false && out.step_delta[i] > 0)) {"),
    ("controller", "motor power loss ignored", "if (!in.motor_power_ok && state_ != State::PowerLoss) {", "if (false && state_ != State::PowerLoss) {"),
    ("controller", "homing kept after power loss", "homed_ = false;  // steps may have been lost with the power", ";"),
    ("controller", "withdrawal goes the wrong way", "retract[i] = p[i] + s * u[i];", "retract[i] = p[i] - s * u[i];"),
    ("controller", "park height ignored after withdrawal", "up[Z] = std::max(retract[Z], config_.park[Z]);", "up[Z] = std::min(retract[Z], config_.park[Z]);"),
    ("step_queue", "step queue counts steps the wrong way", "pending_[axis] += forward_[axis] ? -1 : 1;", "pending_[axis] += forward_[axis] ? 1 : -1;"),
    ("step_queue", "step queue has no low phase", "if (high_[axis]) {", "if (false) {"),
    ("step_queue", "step queue clear does nothing", "void clear() { pending_.fill(0); }", "void clear() {}"),
    ("controller", "CLEAR keeps the homing after a fault", "homed_ = homed_ && !must_rehome;", "homed_ = homed_;"),
    ("controller", "MOVE accepted while another move runs", 'if (state_ == State::Moving) return "error:busy";', ""),
    ("controller", "STOP does not stop", "    request_stop();", "    (void)0;"),
    ("controller", "MOVE accepted before homing", """if (command == "MOVE") {
    if (config_.require_tool && !tool_ready_) return "error:tool";
    if (!homed_) return "error:not_homed";""", """if (command == "MOVE") {
    if (config_.require_tool && !tool_ready_) return "error:tool";"""),
    # not listed: clearing tool_enabled_ on a tool change. It is defence in depth: a change while powered is already a fault, and
    # a fault clears the request, so removing the line changes no behaviour (an equivalent mutant).
    ("controller", "tool powered without TOOL ON", "tool_power_ = tool_enabled_ && tool_ready_ && power_ok_;", "tool_power_ = tool_ready_ && power_ok_;"),
    ("controller", "a drill keeps its power on abort", "tool_ready_ && tool_->cut_on_abort &&", "tool_ready_ && false &&"),
    ("controller", "tool change while powered is not a fault", "if ((was_powered || busy) && state_ != State::Fault && state_ != State::PowerLoss) enter_fault(Cause::Tool);", ""),
    ("controller", "an unknown tool can be switched on", 'if (!tool_ready_) return "error:tool";', ""),
    ("controller", "the withdrawal ignores the tool", "double s = tool_ready_ && tool_->retract_mm > 0.0 ? tool_->retract_mm : config_.retract_mm;", "double s = config_.retract_mm;"),
    ("step_queue", "step queue overflow not reported", "overflow_ = true;", ""),
    ("step_queue", "step queue backlog not clamped", "total = total > 0 ? kMaxPending : -kMaxPending;", ""),
    ("step_queue", "step queue direction inverted", "forward_[axis] = pending_[axis] > 0;", "forward_[axis] = pending_[axis] < 0;"),
    ("board_config", "forbidden pin 0 allowed", "pin == 0 || pin == 3", "pin == 3"),
    ("board_config", "microstepping changed without the tests noticing", "constexpr double kMicrosteps = 8.0;", "constexpr double kMicrosteps = 16.0;"),
    ("board_config", "wrist worm ratio changed without the tests noticing", "constexpr double kWristBTeeth = 80.0;", "constexpr double kWristBTeeth = 40.0;"),
    ("board_config", "duplicate pin allowed by the static check", "constexpr std::array<int, kAxes> kDirPin{17, 18, 8, 9, 10, 11};", "constexpr std::array<int, kAxes> kDirPin{4, 18, 8, 9, 10, 11};"),
]


def run_suite(target, source_text, workdir, name, index):
    """Compiles one suite against a (possibly mutated) copy of the target file and runs it."""
    path, suites, includes = TARGETS[target]
    folder = workdir / f"{name}_{index}"
    folder.mkdir()
    mutated = folder / path.name
    mutated.write_text(source_text, encoding="utf-8")
    sources = [str(mutated if t == path else t) for t in suites[index]]
    flags = [f"-I{folder}"] + [f"-I{d}" for d in includes]
    exe = folder / "tests.exe"
    build = subprocess.run(["g++", "-std=c++17", "-O1", *flags, *sources, "-o", str(exe)],
                           check=False, capture_output=True, text=True)
    if build.returncode != 0:
        # a static_assert that rejects the mutant counts as detection; any other compile error is a bad mutant
        return ("fails" if "static assertion" in build.stderr else "does not compile"), build.stderr.strip().splitlines()[:3]
    result = subprocess.run([str(exe)], check=False, capture_output=True, text=True)
    return ("passes" if result.returncode == 0 else "fails"), result.stdout.strip().splitlines()[-1:]


def run(target, source_text, workdir, name):
    """Runs every suite of the target; the result is `fails` as soon as one fails, naming the suite that caught it."""
    suites = TARGETS[target][1]
    detail = []
    for index in range(len(suites)):
        status, detail = run_suite(target, source_text, workdir, name, index)
        if status != "passes":
            return status, [f"suite {index}"] + list(detail)
    return "passes", detail


def main():
    originals = {name: target[0].read_text(encoding="utf-8") for name, target in TARGETS.items()}
    survivors = []
    with tempfile.TemporaryDirectory() as tmp:
        workdir = Path(tmp)
        for name, text in originals.items():
            status, detail = run(name, text, workdir, f"original_{name}")
            if status != "passes":
                print(f"The unmodified {name} does not pass its tests ({status}): {detail}")
                return 2
            print(f"original {name}: tests pass ({detail[0] if detail else ''})")
        for index, (target, name, old, new) in enumerate(MUTANTS):
            original = originals[target]
            if original.count(old) != 1:
                print(f"SKIPPED {name!r}: the target text occurs {original.count(old)} times (update the mutant list)")
                survivors.append(name)
                continue
            status, detail = run(target, original.replace(old, new), workdir, f"m{index}")
            killed = status == "fails"
            print(f"{'killed  ' if killed else 'SURVIVED'}  {name} ({status}{', ' + detail[0] if killed and detail else ''})")
            if not killed:
                survivors.append(name)
    print(f"\n{len(MUTANTS) - len(survivors)} of {len(MUTANTS)} mutants killed")
    return 1 if survivors else 0


if __name__ == "__main__":
    sys.exit(main())
