AIAYN-creator/monkey-with-a-scalpel/(commit log)

2026-10-30 Add contributing guide, CI and benchmark wording
    CONTRIBUTING.md explains scope, review flow and what must never be
    committed. The CI checks that no forbidden file is tracked and lints the
    Python code. The README now states the working benchmark and how to run
    the installation test. The gitignore whitelist covers the new files.
    Supervised-by: Claude Sonnet 5.5 <noreply@anthropic.com>
2026-10-30 Add gantry and wrist simulation with geometry self-check
    sim_brazo.py models the XYZ gantry, a 0-2 axis wrist, a fixed target and
    the tip-to-target distance in millimetres (card p0-02). The CI runs its
    geometry self-check.
    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
2026-10-30 Add self-correction loop and describe the two-control safety design
    loop_autocorreccion.py closes the loop on the gantry model with a damped
    least-squares step, a per-iteration cap and a CSV log (card p0-03). The
    CI runs it. The README now describes the abort and emergency-stop
    controls and the modular intent of the design.
    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
2026-10-30 Add the Phase 0 self-correction preview to the README
    An animated GIF of the loop on the ideal gantry model, with a link to
    the full MP4. The caption states that backlash and camera noise are not
    simulated yet.
    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
2026-10-30 Add the error model and the Monte Carlo sweep of the loop
    error_model.py adds camera noise, calibration bias, backlash and a finite
    axis step through the two hooks of the self-correction loop. sweep_errores.py
    runs the loop many times per error level and reports where it stops reaching
    50 um (card p0-04). The loop log gains a true_distance_mm column, and the CI
    runs the model self-check and a short sweep.
    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
2026-10-30 Add the controller firmware core and its host tests
    Hardware-independent motion and safety logic (card p1-06): commands, homing,
    soft limits and limit switches, watchdog, stop, and an abort that withdraws
    the needle along its own axis and parks the tool. 85,922 checks run against
    a simulated machine; five deliberately injected safety bugs are all caught.
    It has not run on hardware and there is no board layer yet. The CI builds it
    with strict warnings and runs the tests.
    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
    [controller.cpp, controller.h, test_controller.cpp]
2026-10-30 Record that the firmware core compiles for the ESP32
    Built with arduino-cli and the esp32:esp32 3.3.12 core: 22 percent of
    program storage, 7 percent of RAM, no warnings. Notes the Windows path
    length pitfall found while installing the toolchain.
    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
2026-10-30 Add the provisional parametric CAD of the tool head
    build123d CAD (v0.1) of 14 printed parts and 1 machined plate, with every
    parameter tagged by source. build.py checks each part, the print volume and
    the tool-head assembly for interferences; render.py draws overview sheets.
    All dimensions are assumptions or typical catalogue values: nothing here is a
    measurement and it must not be printed yet. The STL files are not committed.
    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
    [build.py, params.py, params_report.py, render.py]
2026-10-31 Extend the provisional CAD to the whole system (version 0.2)
    Add the frame, the axis chain with its riser, camera mounts, limit switch
    bracket, control panel, Z knob, quick-change knob and an optional active
    wrist, placed in world coordinates in two variants. build.py now also checks
    interferences at the corners of the travel, the wrist swing and the camera
    line of sight (with a negative control). Add mech_review.py, a first-order
    hand calculation with every assumption listed. Nothing here is measured.
    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
    [build.py, mech_review.py, params.py, render.py, system.py]
2026-10-31 Align the simulation and the firmware defaults to 100 mm of travel
    The agreed useful travel is 100 mm per axis (-50 to +50 mm). Use it in the
    simulated gantry and in the firmware default configuration (limit switches
    2 mm beyond the soft limits, park height inside the range), scale the host
    tests, and move the loop's starting pose inside the reachable area (88 mm
    from the target, 26 iterations). Regenerate the README preview and update
    the numbers in the README.
    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
2026-10-31 Fix the bias self-check after the 100 mm travel change
    The loop stops when the measured error is under its 10 um tolerance, so the true
    error ends at the calibration bias within that tolerance. The old 2 um bound only
    held by chance with the previous geometry (it is 4.2 um now).
    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
2026-10-31 Add a mutation check for the firmware tests and cover two safety gaps it found
    The 11 injected faults are now a script. Two survived: a limit switch hit on the
    minimum side and raising the tool to the park height before moving sideways. Both
    now have tests. The mechanical review also compares a printed Z plate with the
    aluminium one.
    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
2026-11-01 Add the provisional ESP32-S3 board layer with TMC2209 drivers
    Pin map, 40 kHz step pulse timer, non-blocking serial and a step queue that is tested on the PC. It compiles for esp32s3 but has never run on hardware. The mutation check now covers 20 faults across the core, the step queue and the pin map, and runs in CI.
    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
2026-11-01 Add the provisional wiring map, checked against the firmware pins
    Cables, conductor counts, estimated lengths and the moving harness come from the CAD parameters and board_config.h. The CI checks that the map and the firmware pins agree.
    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
2026-11-01 Add cable provisions, a real electronics enclosure and a parametric heater plate to the CAD
    Cable clips for the 2020 slot, the electronics tray and lid with eleven connector holes, tie slots on the motor mount, the limit switch bracket and the control panel, and two parts not yet placed (chain mount, tool connector holder). The heater plate under the phantom is the parameter HEATER_T; it raises the phantom and the lowest tip height. The full build passes: 30 parts, no interferences, no blocked line of sight.
    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
    [params.py, system.py]
2026-11-06 Turn the CAD into a registry of modules without changing its result
    Every file in cad/modules/ owns its parts, from the geometry to where they stand in the assembly, and is found automatically. layout.py holds the shared constants and the Pose of the moving parts. A name used twice is an error. The 30 parts, both assemblies, the interference checks and the line of sight give the same numbers as before.
    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
    [build.py]
2026-11-06 Bring the README up to date with the current state of the project
    The status now lists what exists (firmware core and ESP32-S3 board layer with the mutation check, the CAD as a registry of modules, the wiring map, the card plan), the phases cover the whole tool family, and the layout and the commands match the repository.
    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
2026-11-06 Add coordinate frames and camera calibration to the host software
    A sample frame from two landmarks (with the tilt reported and a reference spacing treated as a prior), a pinhole camera fitted by direct linear transform, a plane homography and two-camera triangulation. Self-checks against hand-computed values and synthetic truths run in the CI.
    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
2026-11-06 Add the stiffening, Z nut holder, wrist drive, microscope and specimen fixture modules, and check the wrist at the travel limits
    The build now sweeps the wrist variant at the corners of the travel and swings the wrist at the corners, which it did not before. That found the yoke touching the phantom below a minimum tip height and a tilt hitting camera A, which moved back and up. 38 parts, no interferences, line of sight free.
    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
    [build.py, mech_review.py, params.py, system.py]
2026-11-06 Settle the wrist drive and the axis names: a worm with a split sector, axis B is the rotation about X
    The CAD called the rotation about X axis A, while the firmware and the simulation call it B. The CAD now follows them. The wrist drive stays a worm because it self-locks with the power off and holds the angle during insertion; the split sector takes up the backlash. The board layer sets the steps per degree of B from the 80-tooth sector, and the mutation check covers it (21 faults).
    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
    [board_config.h, controller_board.ino, mutation_check.py, system.py, test_board.cpp]
2026-11-06 Harden the tests and the CI, starting with the CAD
    The CAD now builds in the CI and its report is compared with a committed expectation, so a part that changes or disappears no longer slips by silently. New randomised tests of the controller (400 command sequences with garbage lines, lost steps, power events and an ABORT that must always stop) cover 99 % of its lines together with the unit tests; the CI gates at 95 %, runs every test under the address and undefined-behaviour sanitizers, compiles the board layer for the ESP32-S3 and pins ruff. The mutation check now has 25 faults and runs several test suites. Dependabot watches the actions and the Python packages.
    Supervised-by: Claude Sonne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
    [check_report.py, coverage_check.py, mutation_check.py, test_fuzz.cpp, test_modules.py]
2026-11-06 Run the board build script with bash and mark it executable
    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
2026-11-06 Add the host link: protocol, serial and simulated transports, chained log and a session with the heartbeat
    The simulated transport runs the real controller core on a simulated plant, so the tests cover homing, moves, the watchdog, the ABORT button, a limit fault from lost steps and motor power loss, with every exchange in a hash-chained log. The tests run in the CI.
    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
    [chainlog.py, protocol.py, session.py, test_link.py, transport.py]
2026-11-06 Count lost heartbeats instead of swallowing the error
    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
    [session.py]
2026-11-06 Add the tool interface to the firmware core, with descriptors, a generated table and tests
    The controller reads the id of a mounted tool, refuses a tool it does not know, powers a known one only after TOOL ON, cuts the power of tools that cut on abort, withdraws by the tool's own length and treats a tool change while powered or moving as a fault. Descriptors in tools/ generate the firmware table. Unit, randomised and host-link tests cover it (99 % of the core's lines), and the mutation check has 30 faults.
    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
2026-11-06 Add the tool interface parts and a rack to the CAD, outside the reach of the gantry
    A cam latch, a presence switch mount, the connector holder and a three-position rack segment; three segments stand on the base plate where no tool can reach. With 100 mm of travel the gantry cannot change tools by itself, so the tools are changed by hand in a change pose. The build passes with 44 parts and the CAD expectation is updated.
    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
2026-11-06 Add axis A of the wrist to the CAD and sweep both axes
    The whole wrist now turns about Y through the needle hub on a printed stage plate (wrist_a_base, 14 mm gap). Pose gets phi, the wrist
    and its drive turn with it, and the build sweeps A as well as B: A = +-30 degrees needs the tip at 38 mm or higher, and at the lowest
    tips A is limited to +-5 degrees (+-6.5 already touches the phantom with B = +30). The drive of A is a concept, not geometry.
    The golden report changes by the new part and 14 mm more work_y. All values are provisional.
    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
2026-11-06 Add the eight tool descriptors, models and CAD modules, and the wash station
    Descriptors for the probe, scalpel, drill, fluid tool, gripper, cautery and optical sensor (ids 2 to 8) with the limits their simulation models
    enforce, and the generated firmware table. host/toolsim has a behaviour model of each tool (limits from the descriptor, power needed, safe
    state after an abort) and of the wash station with a carry-over model. cad/modules has a module per tool (printed holders and dummies, not
    placed) and the wash tray (placed, outside the reach of the gantry); cad/tool_check.py checks each tool: valid parts, no overlaps, working
    point, the injector envelope, and the mass under the descripto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
2026-11-06 Add the camera overlay and the LLM interface to the host software
    host/overlay draws tip, target, error, firmware state and anatomical coordinates over simulated camera views, with how each number was
    computed. host/llm is a closed list of capabilities, a deterministic validator (static and dry-run), approval bound to the hash of the plan,
    narration by templates, a hash-chained log and a loop that runs with the model replaced by a script. No real model client and no video yet.
    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
2026-11-06 Pin the GitHub actions of GitHub by commit hash
    The version comment stays so Dependabot keeps updating them.
    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
2026-11-06 Pin the third-party arduino-cli action by commit hash
    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
2026-11-06 Add the tool integration check and run it in the CI
    tools/int_check.py proves that the descriptors, the firmware table, the models, the LLM
    capabilities and the wiring agree, and that each tool can be mounted, powered, aborted and
    changed on the simulated controller.
    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
2026-11-07 Replace the I2C tool bus with a head board on an RS-485 link
    The tool circuits end on a head board (ESP32-C3 class) on the Z carriage that talks to
    the controller over RS-485; the controller needs three GPIOs for all eight tools.
    The control panel gets dual-contact buttons (7 conductors) for the enable loop.
    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
    [wiring.py]
2026-11-07 Add the connection map: every conductor from box pin to machine pin
    cad/connection_map.py builds a netlist from wiring.py and the firmware pins and checks that
    each GPIO appears once and that each cable has the conductors it declares (also in the CI).
    Generated tables and the cable chart are in docs/.
    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
2026-11-07 Lay the stations out for a large travel: X 400, Y 250, Z 150 builds clean
    The tool rack and the wash tray sit inside the reach of the gantry (head parts may touch
    them on purpose), and the control panel, the microscope and both cameras move outside the
    sweep. With the default 100 mm travel the build and the report are unchanged.
    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
2026-11-07 Add CAD renders in docs/cad and show them in the README
    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
2026-11-07 Relicense going forward: AGPL-3.0 for software, CERN-OHL-S v2 for hardware
    Software (firmware, host, tools, simulation) moves to the GNU AGPL-3.0 with a commercial
    licence available; designs and documentation (cad, docs) to the CERN-OHL-S v2; the name and
    logo stay reserved. Each folder carries its LICENSE, the README shows the table, and
    contributions need the contributor grant. Versions up to 82339bb remain MIT.
    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
2026-11-07 Replace the 2020 crossbeam by a printed hollow box with four aluminium rods
    modules/beam.py builds the beam in segments of at most 200 mm (tube, rod bosses, bulkheads),
    with four 8 mm rods through all the bores and an end plate on each side. The section follows
    the X travel (60 x 80 mm, 80 x 100 mm for a large travel) because torsion decides it, as
    mech_review.py shows. The X drive and the cable clips move behind the wider beam. Both the
    default travel and X 400, Y 250, Z 150 build without interferences; the report has 62 parts.
    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
    [mech_review.py, params.py, render.py]
2026-11-07 Refresh the CAD renders and READMEs with the printed beam
    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
2026-11-07 Test beam for mech-viga: printable 400 mm probe, predictions and test protocol
    Supervised-by: Martin Llorens
